wdevore/MC6809P/docs/NVRamProg2.JPG

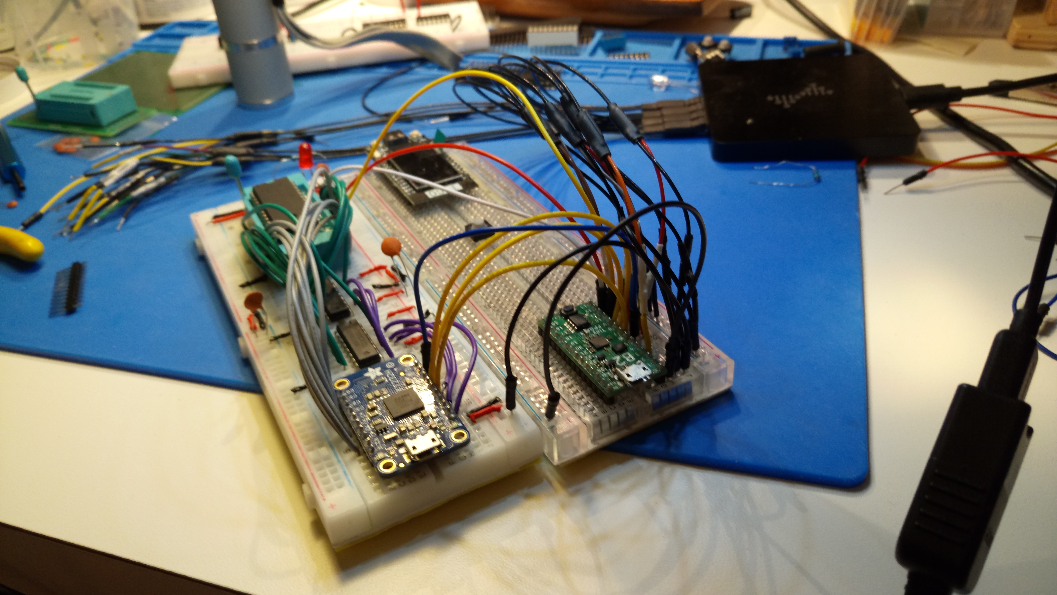
docs/NVRamProg2.JPG
