wdevore/MC6809P/docs/NVRamProg7.JPG

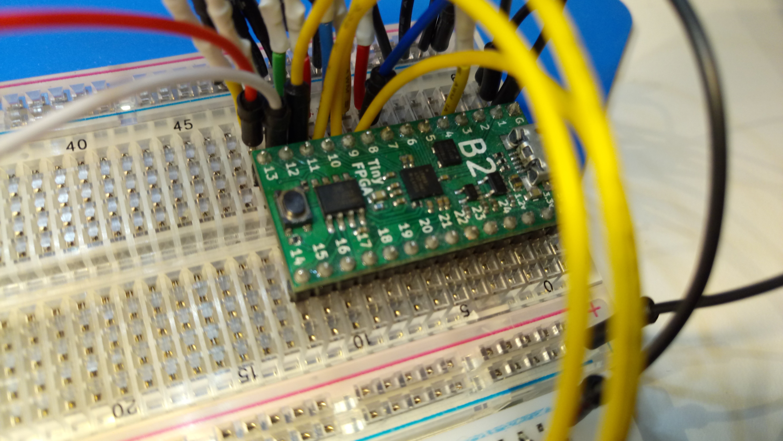
docs/NVRamProg7.JPG
