wdevore/MC6809P/Kicad Schematic.png

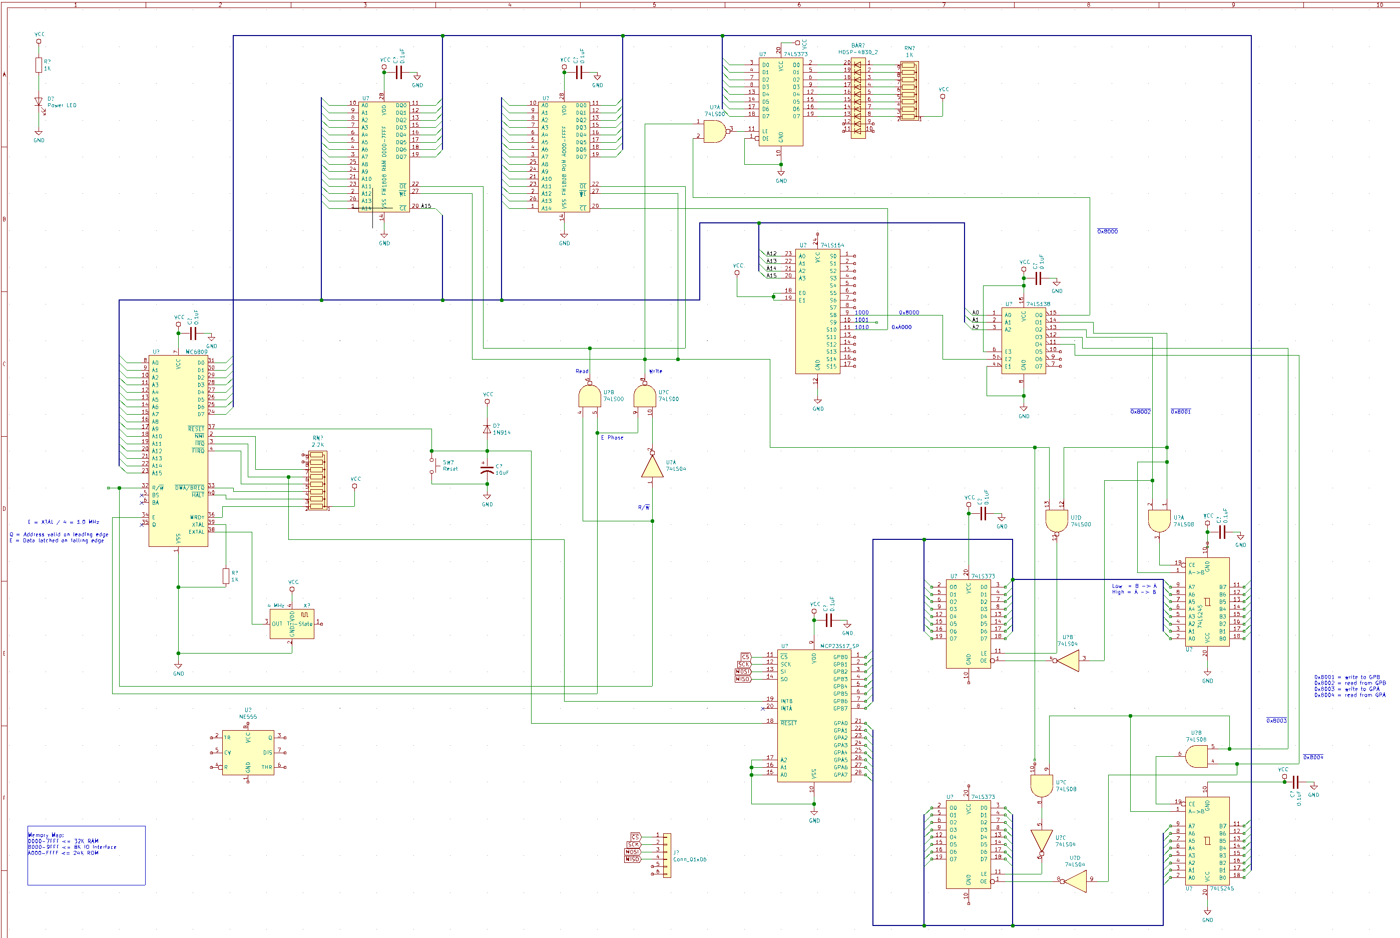
Kicad Schematic.png
