wdevore/MC6809P/(commit log)

2019-10-14 Initial checkin
    [MC6809P.kicad_pcb, MC6809P.sch, ParallelComm.sch, UARTComm.sch, VPIOComm.sch]
2019-10-14 removed usused jumper
    [VPIOComm.sch]
2019-10-14 screen shot
    [VPIOComm.sch]
2019-10-16 added bidirectional comm via registers
    [BidirectionComm.sch, MC6809P.sch, ParallelComm.sch, UARTComm.sch, VPIOComm.sch]
2019-10-16 added bias resistors and refactor reset
    [BidirectionComm.sch, MC6809P.sch]
2019-10-21 added nvram prog
    [BidirectionComm.sch, MC6809P.sch, ParallelComm.sch, UARTComm.sch, VPIOComm.sch, nvram_prog.sch]
2019-10-21 added J connector and labels
    [nvram_prog.sch]
2019-10-28 added clk and pulse circuit. Added go code programmer
    [BidirectionComm.sch, nvram_prog.sch]
2019-11-07 Added clock circuit
    [BidirectionComm.sch, MC6809P.sch, ParallelComm.sch, SystemClock.sch, UARTComm.sch, VPIOComm.sch, nvram_prog.sch]
2019-11-07 cleaned some labels
    [SystemClock.sch, nvram_prog.sch]
2019-11-16 minor touches to schematics added HP1414 Go examples
    [MC6809P.sch, ParallelComm.sch, VPIOComm.sch]
2019-11-27 added Mega2560 Arduino client
    [BidirectionComm.sch]
2019-11-27 added Mega2560 Arduino code
2019-11-27 added more docs
    [nvram_prog.sch]
2019-11-30 updated pin configuration. A0 moved
2019-11-30 updated docs with erase perf board images
2019-12-20 added CAT28C16 programmer and refactor folders and update schemos
    [UART2Comm.sch]
2019-12-27 completed 29C256 programmer. Missing resistors on Data lines.
    [Mega_AT29C256_Programmer.ino, Mega_CAT28C16_Programmer.ino]
2020-01-04 dropped serial1 baud to 250000
    [BidirectionComm.sch, MC6809P.sch, ParallelComm.sch, SystemClock.sch, UART2Comm.sch, UARTComm.sch, VPIOComm.sch, nvram_prog.sch]
2020-01-05 added page reading, fixed disconnected serial1 input noise
    [Mega_AT29C256_Programmer.ino]
2020-01-31 minor cosmetic
    [BidirectionComm.sch, MC6809P.sch, ParallelComm.sch, SystemClock.sch, UART2Comm.sch, UARTComm.sch, VPIOComm.sch, nvram_prog.sch]
